dynoma5/speedster_3d_files/speedsterSpeakerBackPanel.stl

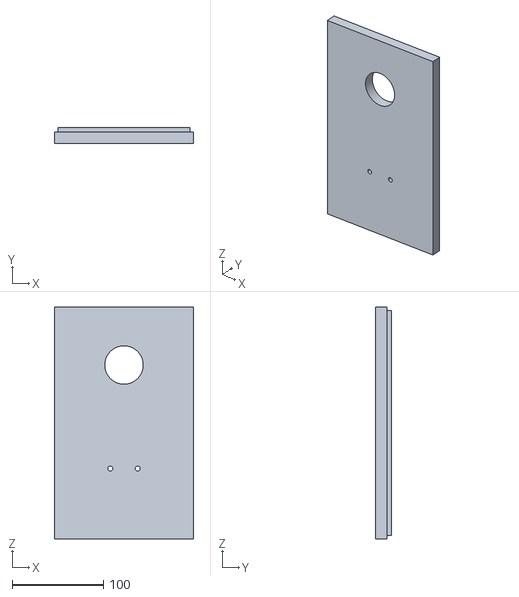
[picture p4: CAD file, 2023-12-29]
speedsterSpeakerBackPanel.stl
152.4 x 17.7 x 254.0
