dynoma5/speedster_3d_files/speedsterSpeaker.stl

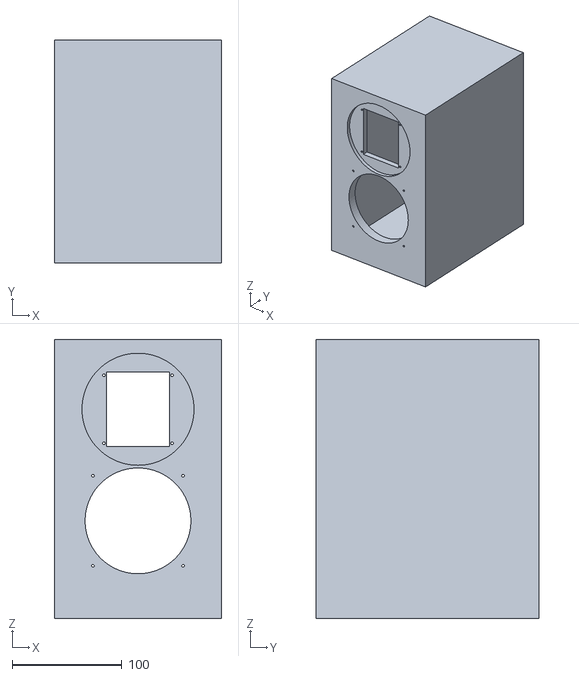
[picture p5: CAD file, 2023-12-29]
speedsterSpeaker.stl
152.4 x 203.2 x 254.0
